dvorak55/chavdai40/README.md

# Chavdai40% Socketをご購入の方はこちら↓
https://github.com/dvorak55/chavdai40socket

# 2020年、2023年発売のChavdai40%をご購入の方で、以前のサポートページをご覧になりたい方はこちら↓
https://github.com/dvorak55/chavdai40/tree/master/2023
