dvorak55/chavdai40/logo_chavdai40/description04.pdf

# 親しみやすい40%キーボード

## はんだ付けはスイッチのみ キーキャップは色々使える

# Chavdai

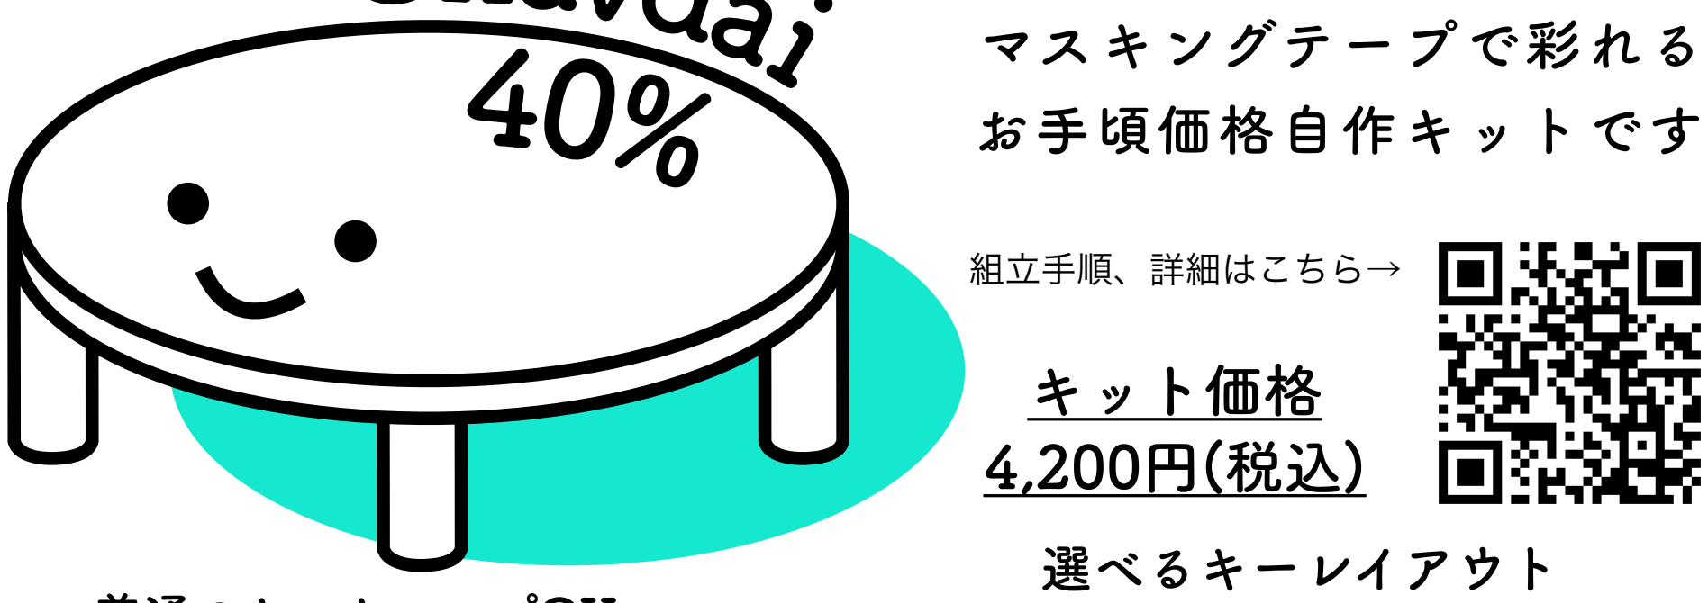
[picture p1: figure]
マスキングテープで彩れる; お手頃価格自作キットです; 組立手順、詳細はこちら→; キット価格 4,200円(税込); 選べるキーレイアウト

## 別途必要な部品

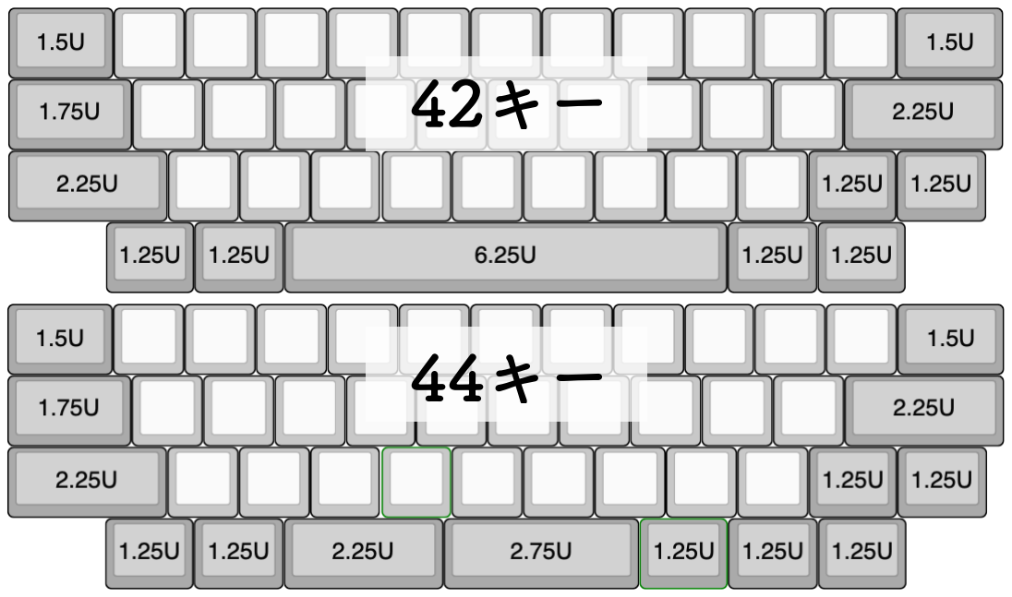
[picture p2: figure]

42キー | 1. PCBマウントのスタビライザー（2U）　2個 2. PCBマウントのスタビライザー（6.25U）　1個 3. PCBマウント（5ピン）のキースイッチ（MX互換）　42個 4. キーキャップセット　1セット 5. USB-C to USB-A ケーブル　1本
スペース分割 44キー | 1. PCBマウントスタビライザー（2U）　4個 2. PCBマウント（5ピン）のキースイッチ（MX互換）　44個 3. キーキャップセット　1セット ※ 2つ目の2.25シフトキー or 2UのBSキーをスペースキー分割に使います 4. USB-C to USB-A ケーブル　1本
デコレーション に必要なもの | 1. マスキングテープ(幅50～100mm) or リメイクシート　←本体の表面と裏 面に貼る用 2. マスキングテープ(幅3mm)　←本体の側面に貼る用 ※テープやシートがあまりに分厚いとキースイッチを挿し込む際に 不具合が発生する可能性があります。

## - 普通のキーキャップOK - スペースキー分割OK

※縦長Enterは未対応

## - ネジ締め一切不要 - デコレーション可能 - QMK対応 - USB-C 搭載済み - MX互換スイッチ対応

## (スペースキーの分割有無)

※展示機のデコレーションに使用したもの
キーキャップ：Tai-Hao ABS Cubic Miami Surf　　リメイクシート：mtリメイクシートKapitza SUN
