dvorak55/chavdai40/logo_chavdai40/description03.pdf

# 親しみやすい40%キーボード

## はんだ付けはスイッチのみ キーキャップは色々使える

# Chavdai

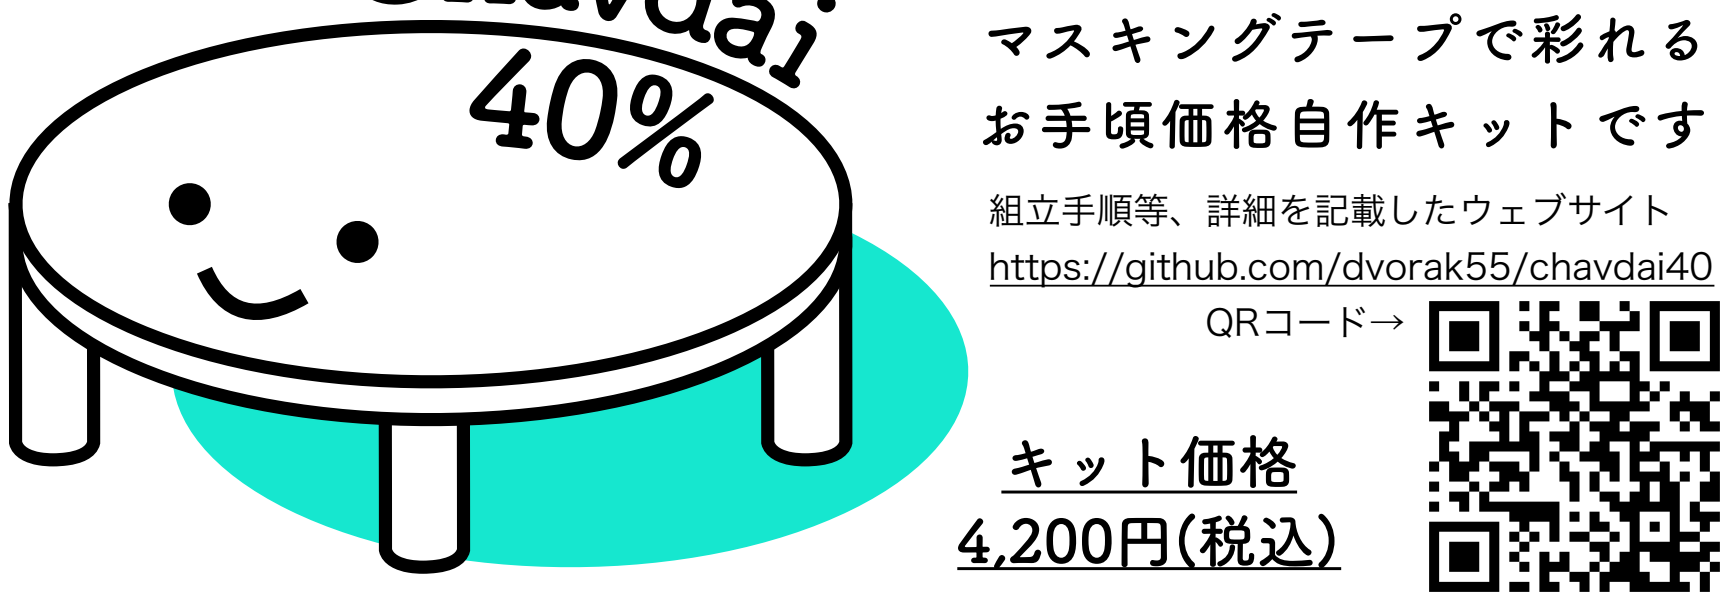
[picture p5: figure]
マスキングテープで彩れる; お手頃価格自作キットです; 組立手順等、詳細を記載したウェブサイト; https://github.com/dvorak55/chavdai40; QRコード→; キット価格 4,200円(税込)
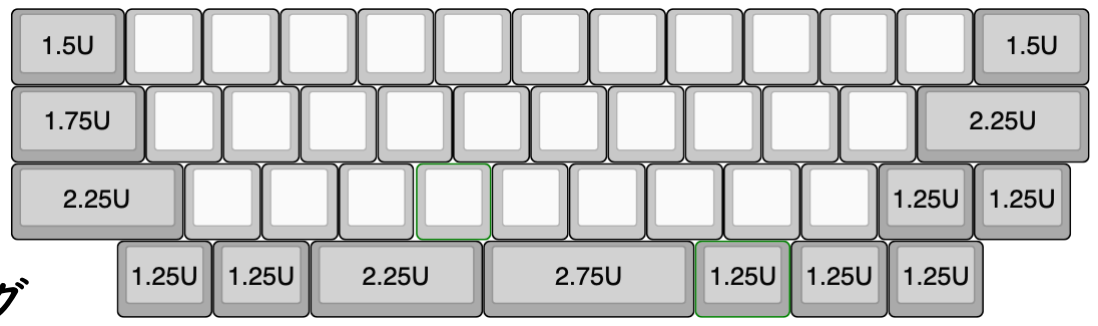
[picture p6: figure]
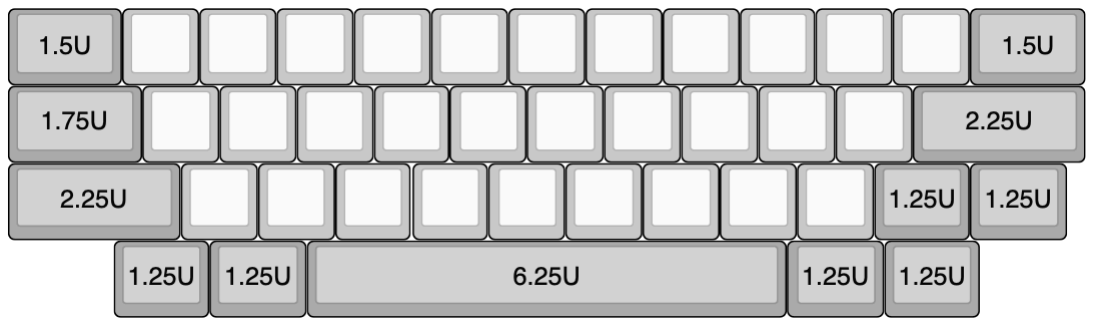
[picture p7: figure]

キーボードとして使うために他に揃えていただく部品
スペースキー 分割しない 42キー | 1. PCBマウントタイプのスタビライザー（2U）　2個 2. PCBマウントタイプのスタビライザー（6.25U）　1個 3. PCBマウント（5ピン）のキースイッチ（MX互換）　42個 4. キーキャップセット　1セット 5. USB-C to USB-A ケーブル　1本
スペースキー 分割する 44キー | 1. PCBマウントタイプのスタビライザー（2U）　4個 2. PCBマウント（5ピン）のキースイッチ（MX互換）　44個 3. キーキャップセット　1セット ※2.25Uシフトキーと二個目の2.75シフトキーが必要です 4. USB-C to USB-A ケーブル　1本
デコレーション に必要なもの | 1. カモ井加工紙のマスキングテープ(幅100mmもしくは幅50mm)もしくは リメイクシート　←本体の表面と裏面に貼る用 2. カモ井加工紙のマスキングテープ(幅3mm)　←本体の側面に貼る用 ※マスキングテープやシートは、カモ井加工紙以外でも使用できます ※テープやシートがあまりに分厚いとキースイッチを挿し込む際に 不具合が発生する可能性があります。
選べるキーレイアウト 特徴 | (スペースキーの分割有無)
- 普通のキーキャップセットが使える
- 高価なGMK等のキーキャップも使える：
この場合スペースキーが分割できます
※JIS等の縦長Enterキーには未対応
- ネジ締めは一切不要
- デコレーション可能：壁紙用マスキング
テープ等で可愛く・格好良く彩れます
- QMKに対応、USB-C端子搭載済み、
Cherry MX互換のキースイッチに対応
- 選んだキーレイアウトによって、
必要な部品が少し異なります
