dvorak55/chavdai40/keylayout_chavdai40/chavdai1-6layout.png

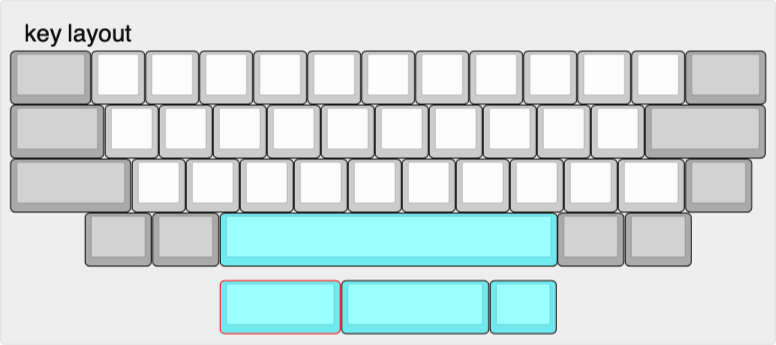
keylayout_chavdai40/chavdai1-6layout.png
