dvorak55/chavdai40/keylayout_chavdai40/chavdai40-itaku.png

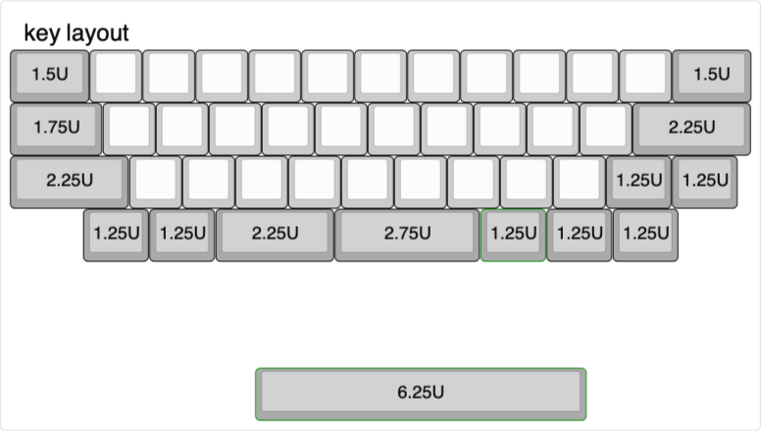
keylayout_chavdai40/chavdai40-itaku.png
