dvorak55/chavdai40/keylayout_chavdai40/configurator-1.png

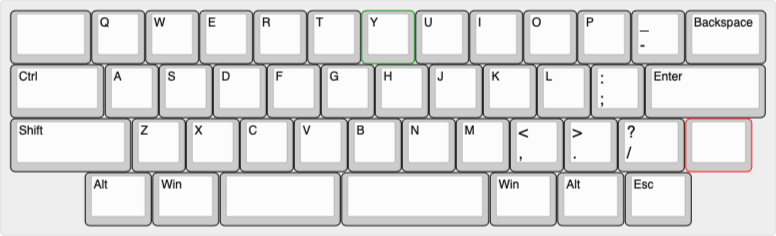
keylayout_chavdai40/configurator-1.png
