dvorak55/chavdai40/logo_chavdai40/description02.pdf

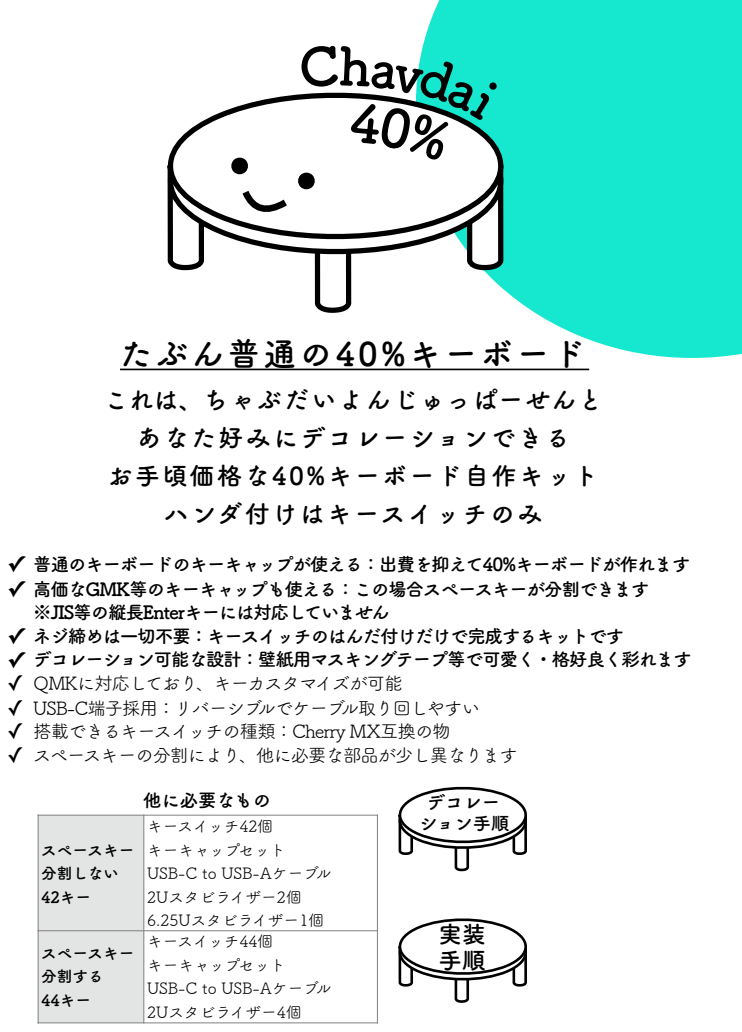
[picture p61: page 1]
たぶん普通の40%キーボード; これは、ちゃぶだいよんじゅっぱーせんと; あなた好みにデコレーションできる; お手頃価格な40%キーボード自作キット; ハンダ付けはキースイッチのみ; デコレー ション手順; Chavdai 40%; 他に必要なもの

✓ 普通のキーボードのキーキャップが使える：出費を抑えて40%キーボードが作れます
✓ 高価なGMK等のキーキャップも使える：この場合スペースキーが分割できます
※JIS等の縦長Enterキーには対応していません
✓ ネジ締めは一切不要：キースイッチのはんだ付けだけで完成するキットです
✓ デコレーション可能な設計：壁紙用マスキングテープ等で可愛く・格好良く彩れます
✓ QMKに対応しており、キーカスタマイズが可能
✓ USB-C端子採用：リバーシブルでケーブル取り回しやすい
✓ 搭載できるキースイッチの種類：Cherry MX互換の物
✓ スペースキーの分割により、他に必要な部品が少し異なります

スペースキー 分割しない 42キー | キースイッチ42個 キーキャップセット USB-C to USB-Aケーブル 2Uスタビライザー2個 6.25Uスタビライザー1個

スペースキー 分割する 44キー | キースイッチ44個 キーキャップセット USB-C to USB-Aケーブル 2Uスタビライザー4個
