dvorak55/chavdai40/logo_chavdai40/description01.pdf

## Chavdai(ちゃぶだい)40%は、お手頃価格な40%

## キーボード自作キットです。組立はスイッチ

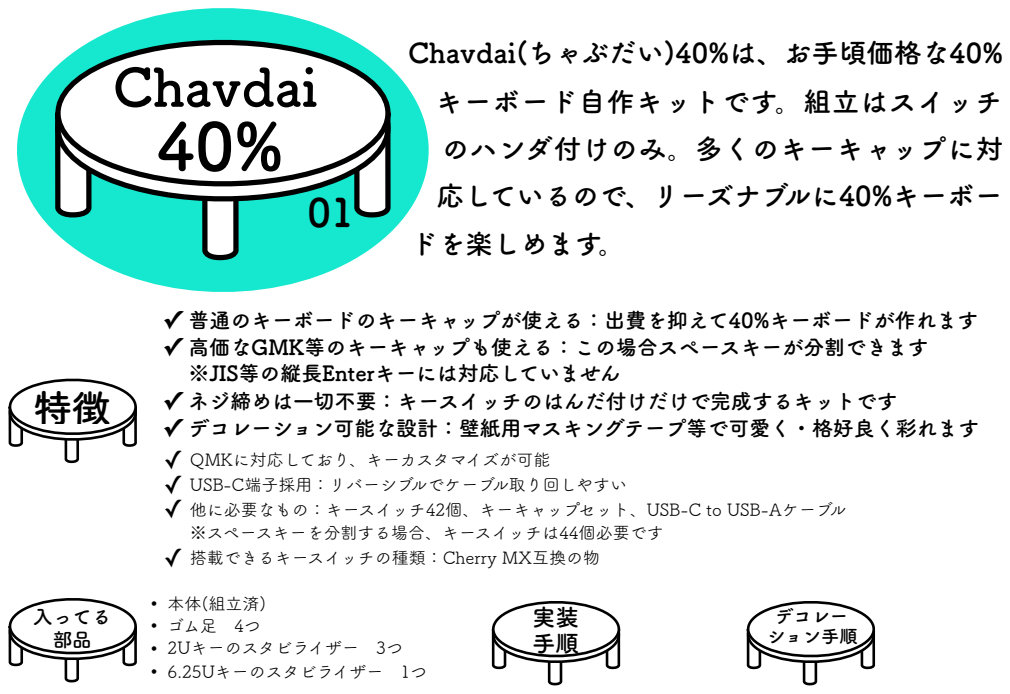
[picture p62: page 1]
のハンダ付けのみ。多くのキーキャップに対; 応しているので、リーズナブルに40%キーボー; ドを楽しめます。; Chavdai; • 本体(組立済) • ゴム足 4つ • 2Uキーのスタビライザー 3つ • 6.25Uキーのスタビライザー 1つ; ✓ 普通のキーボードのキーキャップが使える：出費を抑えて40%キーボードが作れます ✓ 高価なGMK等のキーキャップも使える：この場合スペースキーが分割できます ※JIS等の縦長Enterキーには対応していません; ✓ ネジ締めは一切不要：キースイッチのはんだ付けだけで完成するキットです 特徴; ✓ デコレーション可能な設計：壁紙用マスキングテープ等で可愛く・格好良く彩れます; 入ってる 部品; デコレー ション手順

✓ QMKに対応しており、キーカスタマイズが可能
✓ USB-C端子採用：リバーシブルでケーブル取り回しやすい
✓ 他に必要なもの：キースイッチ42個、キーキャップセット、USB-C to USB-Aケーブル
※スペースキーを分割する場合、キースイッチは44個必要です
✓ 搭載できるキースイッチの種類：Cherry MX互換の物
