dvorak55/chavdai40/logo_chavdai40/logo.pdf

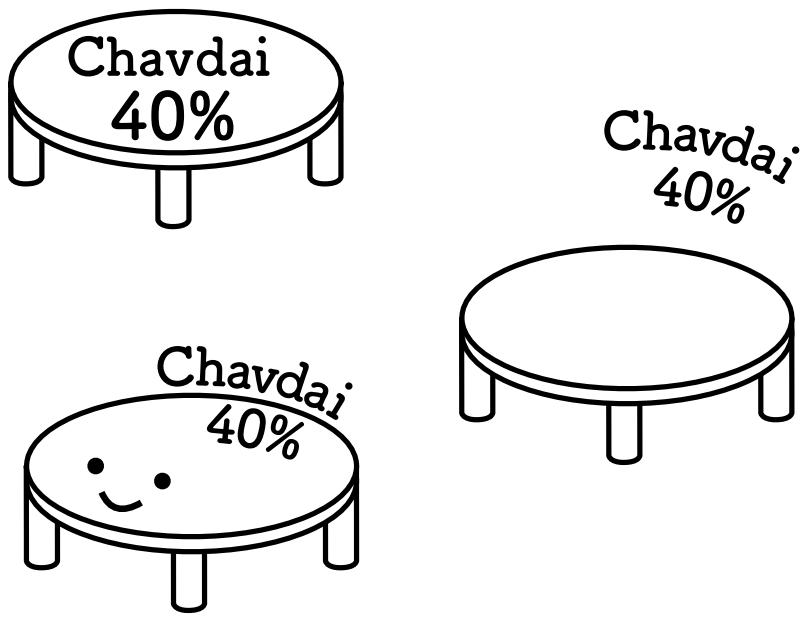
[picture p63: page 1]
Chavdai 40%Chavdai 40%; C havdai 40%
