dvorak55/chavdai40/chavdai40.kicad_pcb

## KiCad design chavdai40.kicad_pcb (2020-09-01)

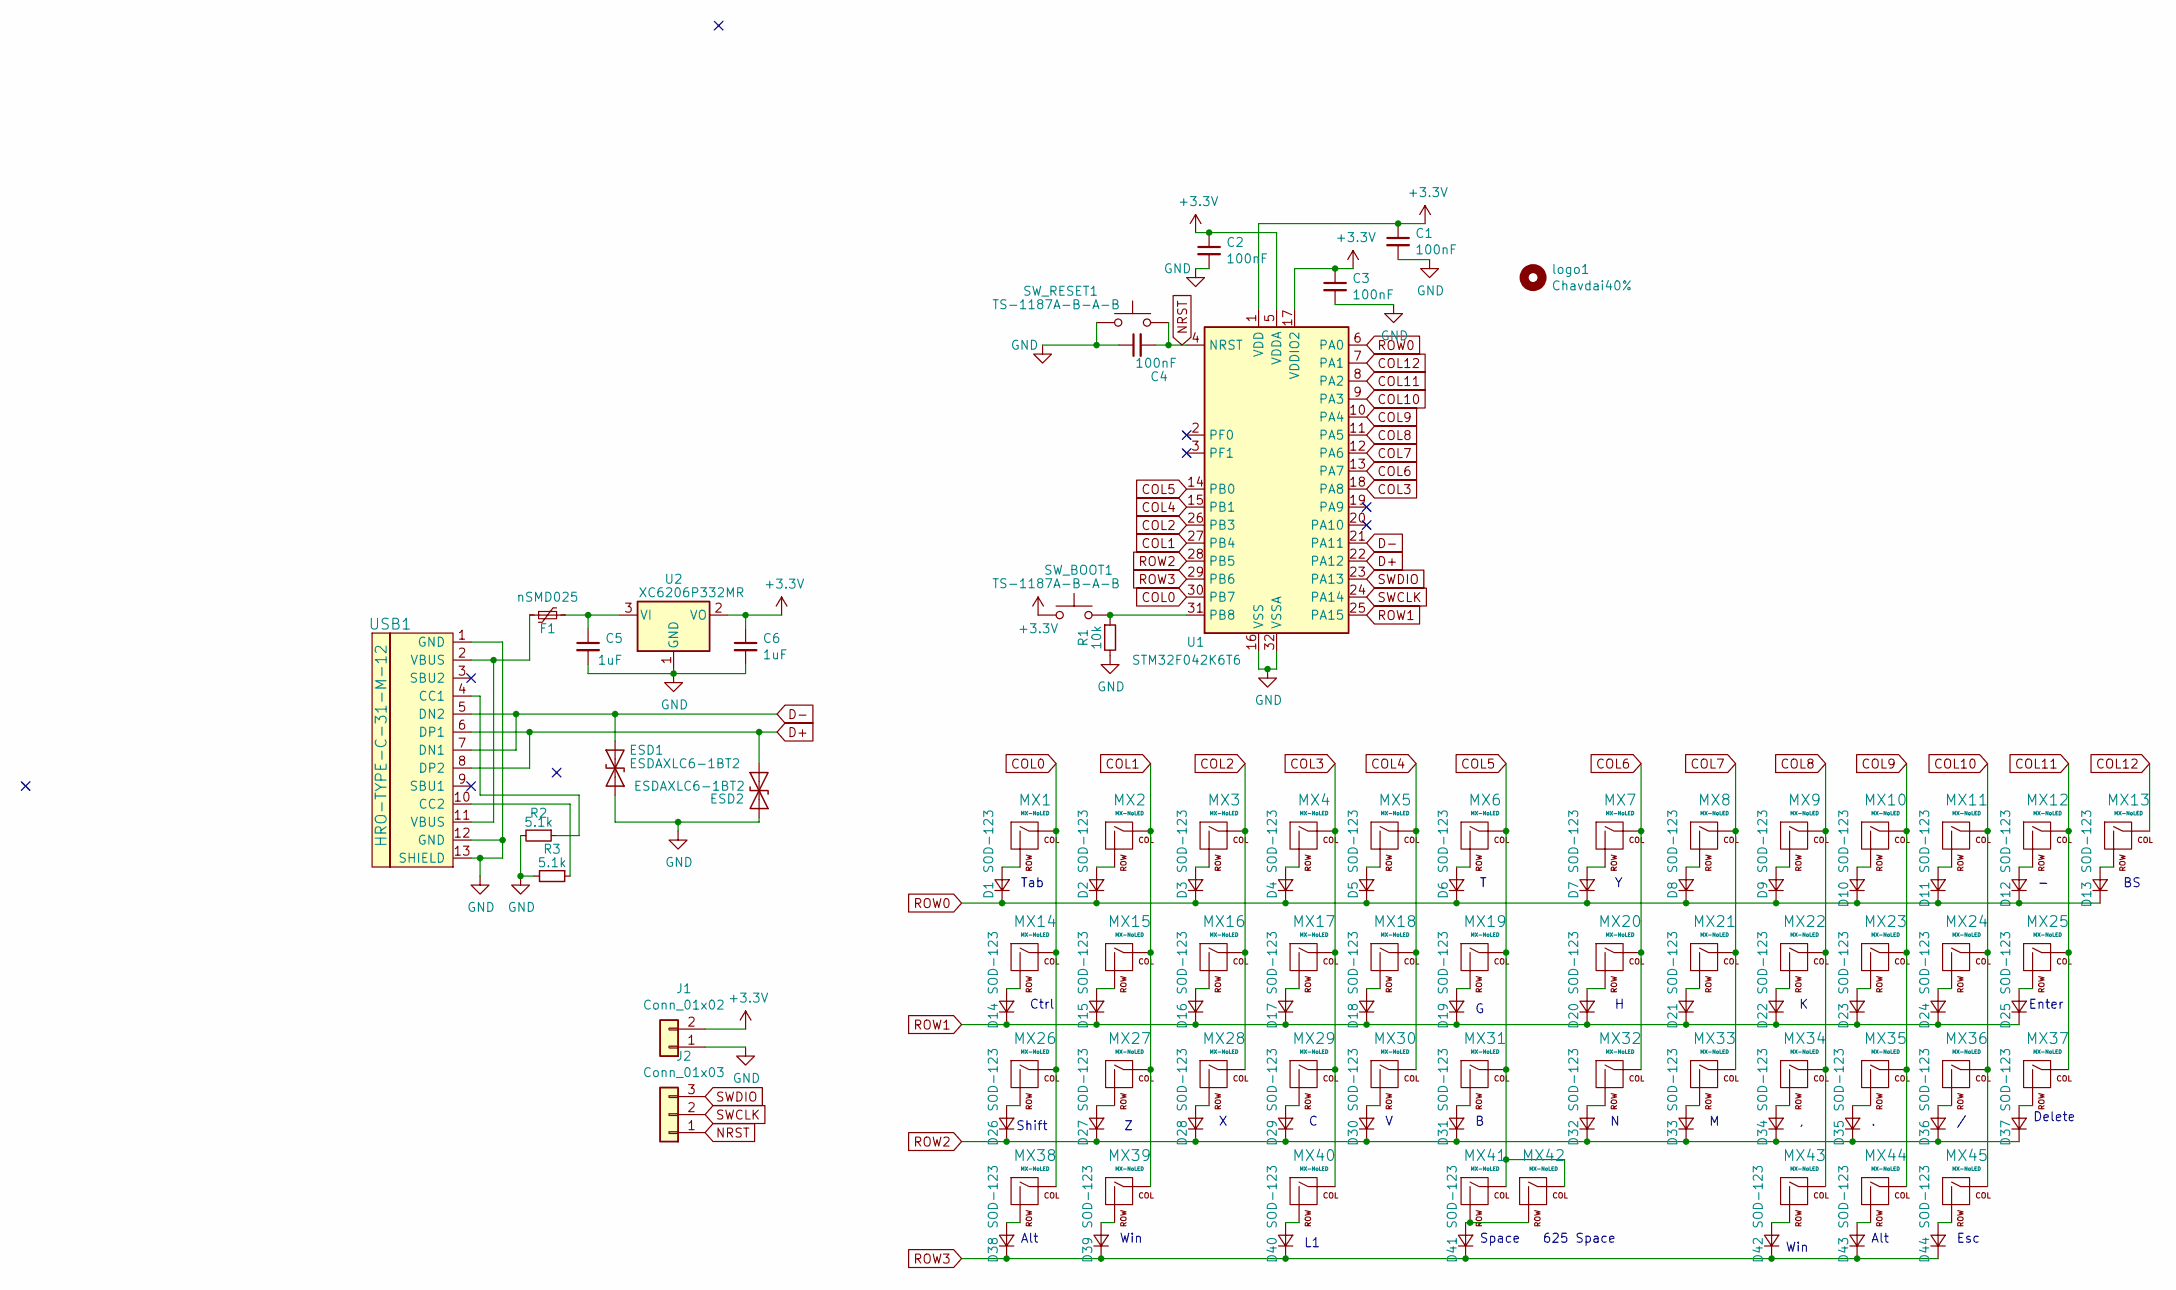
[picture p64: schematic chavdai40.sch]

Parts:
C1, C2, C3, C4: 100nF; C_0402_1005Metric
C5, C6: 1uF; C_0603_1608Metric
D1, D2, D3, D4, D5, D6, D7, D8, D9, D10, D11, D12, D13, D14, D15, D16, D17, D18, D19, D20, D21, D22, D23, D24, D25, D26, D27, D28, D29, D30, D31, D32, D33, D34, D35, D36, D37, D38, D39, D40, D41, D42, D43, D44: SOD-123; D_SOD-123
ESD1, ESD2: ESDAXLC6-1BT2; D_0402_1005Metric
F1: nSMD025; Fuse_1206_3216Metric
J1: Conn_01x02; PinHeader_1x02_P2.54mm_Vertical
J2: Conn_01x03; PinHeader_1x03_P2.54mm_Vertical
MX1, MX13: MX-NoLED; MXOnly-1.5U-NoLED
MX2, MX3, MX4, MX5, MX6, MX7, MX8, MX9, MX10, MX11, MX12, MX15, MX16, MX17, MX18, MX19, MX20, MX21, MX22, MX23, MX24, MX27, MX28, MX29, MX30, MX31, MX32, MX33, MX34, MX35: MX-NoLED; MXOnly-1U-NoLED
MX14: MX-NoLED; MXOnly-1.75U-NoLED
MX25: MX-NoLED; MXOnly-2.25U-NoLED
MX26, MX40: MX-NoLED; MXOnly-2.25U-ReversedStabilizers-NoLED
MX36, MX37, MX38, MX39, MX43, MX44, MX45: MX-NoLED; MXOnly-1.25U-NoLED
MX41: MX-NoLED; MXOnly-2.75U-ReversedStabilizers-NoLED
MX42: MX-NoLED; MXOnly-6.25U-ReversedStabilizers-NoLED
R1: 10k; R_0603_1608Metric
R2, R3: 5.1k; R_0603_1608Metric
SW_BOOT1: TS-1187A-B-A-B; SKQGADE010
SW_RESET1: TS-1187A-B-A-B; SKQGADE010
U1: STM32F042K6T6; LQFP-32_7x7mm_P0.8mm
U2: XC6206P332MR; TSOT-23
USB1: HRO-TYPE-C-31-M-12; HRO-TYPE-C-31-M-12-HandSoldering
logo1: Chavdai40%; logo2-small

Connections:
+3V3: C1.1, C2.1, C3.1, C6.1, J1.2, SW_BOOT1.1, U1.1 (VDD), U1.5 (VDDA), U1.17 (VDDIO2), U2.2 (VO)
COL0: MX1.1 (COL), MX14.1 (COL), MX26.1 (COL), MX38.1 (COL), U1.30 (PB7)
COL1: MX2.1 (COL), MX15.1 (COL), MX27.1 (COL), MX39.1 (COL), U1.27 (PB4)
COL2: MX3.1 (COL), MX16.1 (COL), MX28.1 (COL), U1.26 (PB3)
COL3: MX4.1 (COL), MX17.1 (COL), MX29.1 (COL), MX40.1 (COL), U1.18 (PA8)
COL4: MX5.1 (COL), MX18.1 (COL), MX30.1 (COL), U1.15 (PB1)
COL5: MX6.1 (COL), MX19.1 (COL), MX31.1 (COL), MX41.1 (COL), MX42.1 (COL), U1.14 (PB0)
COL6: MX7.1 (COL), MX20.1 (COL), MX32.1 (COL), U1.13 (PA7)
COL7: MX8.1 (COL), MX21.1 (COL), MX33.1 (COL), U1.12 (PA6)
COL8: MX9.1 (COL), MX22.1 (COL), MX34.1 (COL), MX43.1 (COL), U1.11 (PA5)
COL9: MX10.1 (COL), MX23.1 (COL), MX35.1 (COL), MX44.1 (COL), U1.10 (PA4)
COL10: MX11.1 (COL), MX24.1 (COL), MX36.1 (COL), MX45.1 (COL), U1.9 (PA3)
COL11: MX12.1 (COL), MX25.1 (COL), MX37.1 (COL), U1.8 (PA2)
COL12: MX13.1 (COL), U1.7 (PA1)
D+: ESD2.2 (A2), U1.22 (PA12), USB1.6 (DP1), USB1.8 (DP2)
D-: ESD1.1 (A1), U1.21 (PA11), USB1.5 (DN2), USB1.7 (DN1)
GND: C1.2, C2.2, C3.2, C4.1, C5.2, C6.2, ESD1.2 (A2), ESD2.1 (A1), J1.1, R1.2, R2.2, R3.2, SW_RESET1.1, U1.16 (VSS), U1.32 (VSSA), U2.1 (GND), USB1.1 (GND), USB1.12 (GND), USB1.13 (SHIELD)
NRST: C4.2, J2.1, SW_RESET1.2, U1.4 (NRST)
unnamed: C5.1, F1.1, U2.3 (VI)
unnamed: D1.2 (A), MX1.2 (ROW)
unnamed: D2.2 (A), MX2.2 (ROW)
unnamed: D3.2 (A), MX3.2 (ROW)
unnamed: D4.2 (A), MX4.2 (ROW)
unnamed: D5.2 (A), MX5.2 (ROW)
unnamed: D6.2 (A), MX6.2 (ROW)
unnamed: D7.2 (A), MX7.2 (ROW)
unnamed: D8.2 (A), MX8.2 (ROW)
unnamed: D9.2 (A), MX9.2 (ROW)
unnamed: D10.2 (A), MX10.2 (ROW)
unnamed: D11.2 (A), MX11.2 (ROW)
unnamed: D12.2 (A), MX12.2 (ROW)
unnamed: D13.2 (A), MX13.2 (ROW)
unnamed: D14.2 (A), MX14.2 (ROW)
unnamed: D15.2 (A), MX15.2 (ROW)
unnamed: D16.2 (A), MX16.2 (ROW)
unnamed: D17.2 (A), MX17.2 (ROW)
unnamed: D18.2 (A), MX18.2 (ROW)
unnamed: D19.2 (A), MX19.2 (ROW)
unnamed: D20.2 (A), MX20.2 (ROW)
unnamed: D21.2 (A), MX21.2 (ROW)
unnamed: D22.2 (A), MX22.2 (ROW)
unnamed: D23.2 (A), MX23.2 (ROW)
unnamed: D24.2 (A), MX24.2 (ROW)
unnamed: D25.2 (A), MX25.2 (ROW)
unnamed: D26.2 (A), MX26.2 (ROW)
unnamed: D27.2 (A), MX27.2 (ROW)
unnamed: D28.2 (A), MX28.2 (ROW)
unnamed: D29.2 (A), MX29.2 (ROW)
unnamed: D30.2 (A), MX30.2 (ROW)
unnamed: D31.2 (A), MX31.2 (ROW)
unnamed: D32.2 (A), MX32.2 (ROW)
unnamed: D33.2 (A), MX33.2 (ROW)
unnamed: D34.2 (A), MX34.2 (ROW)
unnamed: D35.2 (A), MX35.2 (ROW)
unnamed: D36.2 (A), MX36.2 (ROW)
unnamed: D37.2 (A), MX37.2 (ROW)
unnamed: D38.2 (A), MX38.2 (ROW)
unnamed: D39.2 (A), MX39.2 (ROW)
unnamed: D40.2 (A), MX40.2 (ROW)
unnamed: D41.2 (A), MX41.2 (ROW), MX42.2 (ROW)
unnamed: D42.2 (A), MX43.2 (ROW)
unnamed: D43.2 (A), MX44.2 (ROW)
unnamed: D44.2 (A), MX45.2 (ROW)
unnamed: F1.2, USB1.2 (VBUS), USB1.11 (VBUS)
unnamed: R1.1, SW_BOOT1.2, U1.31 (PB8)
unnamed: R2.1, USB1.4 (CC1)
unnamed: R3.1, USB1.10 (CC2)
ROW0: D1.1 (K), D2.1 (K), D3.1 (K), D4.1 (K), D5.1 (K), D6.1 (K), D7.1 (K), D8.1 (K), D9.1 (K), D10.1 (K), D11.1 (K), D12.1 (K), D13.1 (K), U1.6 (PA0)
ROW1: D14.1 (K), D15.1 (K), D16.1 (K), D17.1 (K), D18.1 (K), D19.1 (K), D20.1 (K), D21.1 (K), D22.1 (K), D23.1 (K), D24.1 (K), D25.1 (K), U1.25 (PA15)
ROW2: D26.1 (K), D27.1 (K), D28.1 (K), D29.1 (K), D30.1 (K), D31.1 (K), D32.1 (K), D33.1 (K), D34.1 (K), D35.1 (K), D36.1 (K), D37.1 (K), U1.28 (PB5)
ROW3: D38.1 (K), D39.1 (K), D40.1 (K), D41.1 (K), D42.1 (K), D43.1 (K), D44.1 (K), U1.29 (PB6)
SWCLK: J2.2, U1.24 (PA14)
SWDIO: J2.3, U1.23 (PA13)

Notes on the sheet:
Esc
Alt
Win
Delete
Enter
Space
Ctrl
Shift
Tab
625 Space

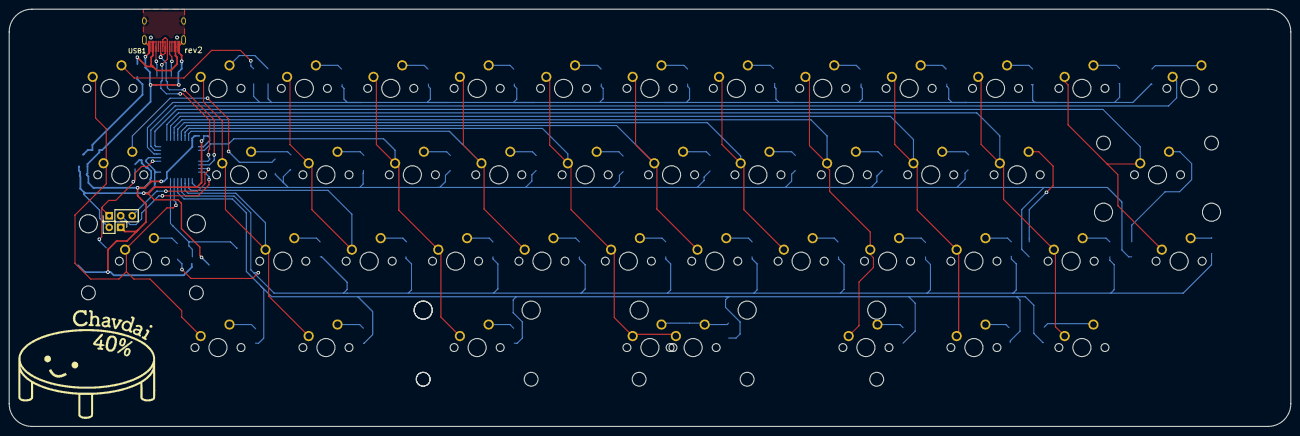
[picture p65: board chavdai40.kicad_pcb from above]

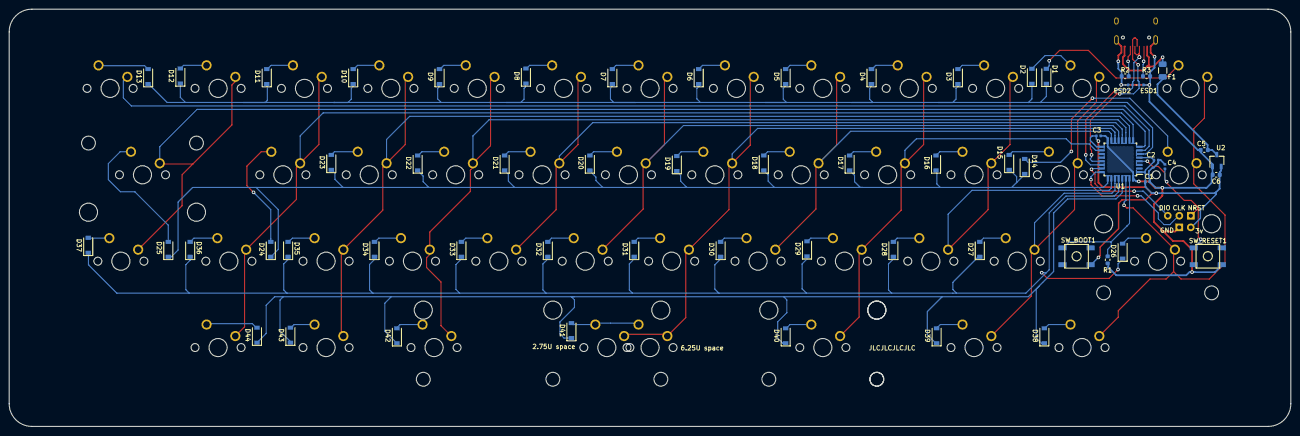
[picture p66: board chavdai40.kicad_pcb from below]

Board: 2 copper layers, 282.6 x 92.0 mm, 109 parts (60 on the bottom side), 73 nets.
