dvorak55/chavdai40/(commit log)

2020-05-02 kicad init
    [chavdai40.kicad_pcb, chavdai40.sch]
2020-05-02 add footprint libraries
2020-05-03 make a schematic
    [chavdai40.sch]
2020-05-04 usb 22ohm register remove; pas-con remove
    [chavdai40.sch]
2020-05-08 2020-05-09 PCB dekita
    [chavdai40.sch]
2020-05-17 tabun dekita
    [chavdai40-B_Cu.gbl, chavdai40-B_Mask.gbs, chavdai40-B_Paste.gbp, chavdai40-B_SilkS.gbo, chavdai40-Edge_Cuts.gm1, chavdai40-F_Cu.gtl, chavdai40-F_Mask.gts, chavdai40-F_Paste.gtp]
2020-07-25 add keymap picture
    [chavdai40.kicad_pcb]
2020-09-01 update chavdai pcb design(rev2)
    [chavdai40-bp.kicad_pcb, chavdai40.kicad_pcb, chavdai40.sch]
2023-07-29 white pcb photo add
2023-07-29 Update README.md
    add white pcb photos
2023-12-12 test back panel kicad file added.
    [chavdai40-bp.kicad_pcb, chavdai40-bp3.kicad_pcb, chavdai40-bp4.kicad_pcb]
